HWXLR8/beef-board/(threads)

Thread 10 (2023-06-08):

PCB does not revert back to reactive lighting mode after entering HID mode

HWXLR8, 2023-06-08:

Closed 2023-08-30.

Thread 6 (2023-06-08):

TT drops inputs on startup

HWXLR8, 2023-06-08:
@supervaka wondering if you have encountered such issues. Occurs on V1+V2.

Steps to reproduce:

1. launch iidx
2. card in
3. select mode (in my case p-free)
4. when using the TT to select time, there are a few seconds of no response

Once the TT begins responding it is fine for the entire session and all sessions afterwards, but relaunching the game seems to cause it.

HWXLR8, 2023-12-18:
I have not been able to reproduce this issue on any device other than the PWAN. I am wondering if this may be an issue with DAO cheaping out on the PWAN photo-interrupters/related HW. This occurred on both the stock PWAN pcb, and all revisions of beef board. Since beef boards are out in the wild now, if nobody reports the same issue within the next month, I will close.

Closed 2024-01-12.

Thread 16 (2023-12-17):

TT reading innacurately on rapid rapid inputs

Mechada2dx, 2023-12-17:
When spinning the turntable slowly it cycles through fine. but when spinning faster, it looks like a temporal aliasing issue might be happening. Tried on a DAO PCB (SS001 V1.20) with the exact same setup, and I didn't encounter any issues similar to this one.

Going back to 72 teeth plate with the beef-board made everything work as it should.

HWXLR8, 2023-12-18:
renaming this issue. Since we confirmed this also occurs on 80T plate, I am convinced this will occur on any TT given a rapid enough input. Characteristics of this failure are that given a rapid enough input frequency, TT reading will appear to slow down, and occasionally read the wrong direction. All of these are indicative of dropped inputs.

Closed 2024-01-28.

Thread 17 (2023-12-19):

Add option to turn on/off button LEDs

Mechada2dx, 2023-12-19:

HWXLR8, 2023-12-19:
@supervaka don't think this should be too difficult. What are you thoughts on toggling this using a button combo?

Closed 2024-01-26.

Thread 18 (2023-12-19):

Add Voltex FW mode

HWXLR8, 2023-12-19:
Been doing some thinking about this one, and it looks like we are going to need a special FW mode for voltex. There are a couple of hurdles:

1. The [encoders used in cryto's voltex controller](https://www.sensatec.co.jp/e/products/catalog.php/293/ST-ELV-24X35B-K_EN.pdf]) use a single 3 pin connector with a variable voltage output. Our design was made with the assumption that controllers will always use encoders with 2 data lines (either in a 2x 3pin format or combined in a single 4pin). As this is not the case, we can re-use one of the 3-pin encoder inputs as an input for these voltex encoders, but we will have to change how the input is handled in FW.
2. The lighting effects run down the sides on the SVRE9, which would also need special FW. Not even sure what type of LEDs this thing uses, but I will experiment and find out.

For now I think it is acceptable to have this a compile-time flag, eventually I would like this to be toggled using a button combo.

Assigning this to myself for now, @supervaka feel free to chime in with your thoughts

HWXLR8, 2024-05-13:
Support for sensatec encoders has been added in V6. We can keep this issue on hold until you have a board in your hands to try out.

ASleepyCat, 2024-05-13:
> Support for sensatec encoders has been added in V6. @ASleepyCat We can keep this issue on hold until you have a board in your hands to try out.

Since I only have an SVSE5, I won't be able to help on RGB LED stuff with the SVRE9 and FAUCETWO.

HWXLR8, 2024-05-13:
> Since I only have an SVSE5, I won't be able to help on RGB LED stuff with the SVRE9 and FAUCETWO.

No problem, LED support is low priority. I will eventually get my hands on a FAUCETWO

Closed 2024-06-26.

Thread 20 (2024-01-06):

Remote USB board with USB-C

ASleepyCat, 2024-01-06:
Instead of requiring two USB cables to power the IO board, develop a remote USB board that only requires one USB input (probably USB-C with PD).

HWXLR8, 2024-01-06:
Thanks for the feature request! The whole idea of of having a remote board was to allow the flexibility to implement such a feature in the future, and it is indeed on the development roadmap, albeit low priority.

ASleepyCat, 2024-06-14:
Apparently a USB-C specific USB 3.x mode can supply up to 3A? https://en.wikipedia.org/wiki/USB-C#USB_3.0/3.1/3.2
This might be enough where USB PD isn't needed.

HWXLR8, 2024-06-14:
Unfortunately the AT90USB1286 is not USB3.0 compliant, so this would not work.

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

I think we should still be able to make it work by integrating a USB PD controller on the remote board, but I have yet to do any experiments with this.

ASleepyCat, 2024-06-19:
I managed to power on my PHOENIXWAN with one USB-C cable using this [USB-C breakout board](https://www.amazon.com.au/dp/B0CXS6X4T6?psc=1&ref=ppx_yo2ov_dt_b_product_details). I think we could fairly easily adapt this design onto our daughter board.

It draws just under 2A with all lights on at full bright.
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

HWXLR8, 2024-06-21:
I agree, we could easily adapt this, but I only have 1 concern. USB3.0 and 3.1 (even if you're using USB-C) still only has a power cap of 900mA. Your motherboard is just violating those specifications (as many do). Furthermore, the AT90USB1286 is only USB2.0 compliant. It is my understanding that the USB PD specification is entirely separate from the USB2/3/3.1 spec and will allow for a negotiation of higher currents even for USB2.0.

ASleepyCat, 2024-06-21:
Are you sure? On Texas Instruments's USB Type-C and PD PDF, they list USB 2.0 w/ up to 3A/15W as one of the most common uses cases (https://www.ti.com/lit/wp/slyy109b/slyy109b.pdf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)

I've also read on various threads that USB power specs are actually minimum guarantees and not limits, although I don't know have a primary source for that.

HWXLR8, 2024-06-21:
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
Well would you look at that. I had no idea that this was the case. This is fantastic news, thanks for bringing it to my attention.

As for the minimum guarantees, for our use case a "minimum guarantee" is equivalent to a power cap. We do not know who will be plugging the device into what, and if their mobo only supports the minimum gurantee, we will trigger over-current protection. Regardless, if we offer USB-C this is a non-issue. I still wish to offer both choices, and as long as we make it clear in the documentation the limitations of USB-B, this should be no problem.

HWXLR8, 2025-05-02:
I have revisited this today, and I believe that the minimum guarantee of 1.5A would not be sufficient for our use case (your example shows ~2A peak current draw). Not all PC motherboards with USB-C ports will support the higher current modes:

> USB-C ports can advertise higher current capabilities-specifically, 1.5A or 3A at 5V-via the CC (Configuration Channel) pins. However, this is not mandatory for all USB-C ports. Only ports that are specifically designed and configured to provide 3A at 5V will do so; others may only offer the default current.

I wouldn't want someone to plug in a beef board just because its USB-C only to trigger OCP on their motherboard. @ASleepyCat what are your thoughts?

ASleepyCat, 2025-05-02:
> I wouldn't want someone to plug in a beef board just because its USB-C only to trigger OCP on their motherboard. [@ASleepyCat](https://github.com/ASleepyCat) what are your thoughts?

YubiDeck has two USB-C ports where you can plug in both cables if your ports can't supply enough power on one cable. Maybe we can do something similar?

I also think Windows will step in if it detects a USB device drawing too much power, I got that warning when I tried using the remote board with only one cable.

If we're going to stick with using two cables minimum, I think we should replace the USB-B ports with USB-C since I think people have more USB-C cables lying around than USB-B cables.

Thread 21 (2024-01-09):

Set up guide?

ASleepyCat, 2024-01-09:
Wiring up the buttons is straightforward and work fine, but the turntable is unresponsive (both in spicecfg and in Windows' controller testing tool) when connecting both photo interrupter cables to `DAO_E1P1` and `DAO_E2P1` . If I connect the second cable to `DAO_E1P2`, it causes spicetools to crash when setting up the analog controls. The turntable and centre bar LEDs also don't turn on when their cables are connected to `TT_LED` and `DAO_BAR` (centre bar lighting isn't implemented so that's understandable).

I'm probably doing something wrong, so could you detail which cables connects where?

ASleepyCat, 2024-01-09:
I changed back to the stock board and everything works fine there, so it's an issue with my board,

ASleepyCat, 2024-01-09:
Nevermind, for some reason I confused the TT headers and everything works now.

HWXLR8, 2024-01-09:
PM'd on sows

Closed 2024-01-09.

Thread 22 (2024-01-09):

Digital turntable input

Mechada2dx, 2024-01-09:
Mostly to play Lunatic Rave 2. Maybe a button combination or a required key to hold while plugging in?

HWXLR8, 2024-01-09:
Could you be a bit more specific as to what the issue is here? Is digital turntable input not working for you?

Mechada2dx, 2024-01-09:
is digital input even a thing with the beef-board?

HWXLR8, 2024-01-09:
@supervaka I remember you tested digital TT and it worked, am I misaken? Referencing the poorly named `analog_turntable.h`

HWXLR8, 2024-02-26:
@ASleepyCat no rush, as usual. Just reassigning.

Closed 2024-03-03.

Thread 28 (2024-01-18):

HWB left floating

HWXLR8, 2024-01-18:
HWB (PIN PE2) is left floating which causes undefined behaviour when trying to enter bootloader. According to the datasheet for the AT90USB1286:

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

This sequence is required to enter the bootloader.

HWXLR8, 2024-04-16:
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
Teensy++ schematic for reference

Thread 31 (2024-01-20):

Implement missing turntable lighting effects

ASleepyCat, 2024-01-20:
Demo can be seen in [tokaku's review](https://youtu.be/q30dw-_Zi90?t=113&si=M5yStXKrlUd08NM7) of the original PHOENIXWAN, which should be the same across the + and LMT versions of the con.

- [x] #43
- [x] #37
  * This can be improved to be prettier
- [x] #48
  * User adjustable shifting speed?
- [x] Static rainbow
- [x] Reactive spinning rainbow
  * The stock board's implementation feels pretty laggy and stuttery, hopefully we can avoid the same shortcomings
- [x] Reactive
  * This is currently a two-tone effect, maybe change it to be more like the stock board? Could also keep the current effect as a different mode
- [x] Breathing
- [x] #52

ASleepyCat, 2024-01-20:
infinitas-arcin and roxy-firmware both use FastLED for their RGB effects, but that requires us to switch over to C++ (at least partially).

I tried to make a PoC, but I ran into weird compilation errors after including FastLED. Could just be an issue with how old my install of `avr-gcc` is, haven't tested it with a recent version yet.

HWXLR8, 2024-01-20:
I am aware of FastLED, but I have never used it myself. I was under the impression that it had a dependency on core Arduino libraries, is that not the case? For the record I don't have a problem with switching to C++.

ASleepyCat, 2024-01-21:
FastLED is available as a library in the Arduino IDE, but there's no hard dependency.

Closed 2024-02-21.

Thread 35 (2024-01-22):

Add support for PHOENIXWAN audio jack

ASleepyCat, 2024-01-22:
PWANs have an audio jack where you can plug in an audio source to get audio-reactive centre bar effects. It would be nice to have this to have complete support for all of the PWAN's features.

HWXLR8, 2024-01-22:
Our current PCB is incapable of supporting this and would require a new revision. This was a notable omission during the design since I am not sure it is possible to analyze audio in real time using our microcontroller. I believe the phoenixwan offloads this to a separate IC. Althought it is nice to have, the effort here would be would be considerable and is unlikely to be done in the future unless somebody else picks this task up. Marking as low priority.

Thread 42 (2024-01-30):

B8-B11 not fully supported by INFINITAS

Mechada2dx, 2024-01-30:
I've been testing INFINITAS with beef-board and from what I can see the game only reads from B9 to B12 respectively for start button and stuff. I can see this still working fine for a 2 button controller since you can just plug in B9 and B10, but for PWAN/RED (4 button controllers overall) this could become an issue specially for a RED since you need 2 PCBs.

HWXLR8, 2024-01-30:
@ASleepyCat / @supervaka I have confirmed on my end that B8 is unresponsive on infinitas. What do you say we kill B8 and just map B1-B7 then B9-B12?

Closed 2024-02-26.

Thread 44 (2024-02-01):

Version 5 PCB to-do list

HWXLR8, 2024-02-01:
- [x]  Fix chip reset (https://github.com/HWXLR8/beef-board/issues/28)
- [x]  Reverse 4 pin encoder pin ordering (5ad248a44e940dccef677540d5273de8867dade5)
- [x]  Add jumper between BUS and AUX 5V (016214301a05c4844d6649bfeba64fc961c18a41)
- [x] Move pwan AUX 2-pin closer to 5-pin (7a32bb05fe54354f62b4c05a49bae48dec875169)
- [x] Add new slikscreen (044856f65555a47e1522f14873f55c4edff88f71)
- [x] Update BOM in README (114403c7b63636c8a7de8c8b4bd2b4dd8c75e62a)
- [x] Update PCB pics
- [x] Fix silkscreen to reflect missing B8 if necessary (N/A)
- [x] Add SDVX silkscreen (N/A)
- [x] Move 2N7002 transistors into clear view (4a06a141ca6fd4496f06b375f950cd44f228dda7)

ASleepyCat, 2024-03-14:
Would it be possible to relocate the USB power headers closer to the edge of the board? I managed to damage the 2-pin power cable while trying to get it out since it was so taught.

HWXLR8, 2024-03-14:
No problem, added to the list.

Closed 2024-05-04.

Thread 69 (2024-04-26):

Add support for AC SDVX encoders

HWXLR8, 2024-04-26:
https://www.sensatec.co.jp/e/products/catalog.php/488/ST-ELV-24Y36G_EN.pdf

HWXLR8, 2024-04-27:
9e67e29ac9a81033c396567d0afec199287f518a

HWXLR8, 2024-05-08:
V5 uses a 3pin JST ZH connector for SDVX, and the pinout is reversed... JST PH seems to fit. The correct connector according to the datasheet is ZHR-3, whatever that is...

HWXLR8, 2024-05-13:
Fixed in v6

Thread 71 (2024-05-11):

V6 PCB to-do list

HWXLR8, 2024-05-11:
- [ ] move right group of JSTs equidistant from mounting holes
- [x] fix SDVX connector size and pinout (https://github.com/HWXLR8/beef-board/issues/69)

Closed 2024-05-13.

Thread 73 (2024-05-16):

Binding inputs on first connect causes incorrect reading

HWXLR8, 2024-05-16:
I believe we discussed this issue before, but when I am binding buttons, sometimes the first input is incorrectly read as either `Z-` or `Y-`. Just happened to me now based on latest commit (4f61eb2b061f3766c839e723c38ace13b96b4ea2). Testing on V3, but that should not make a difference.
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

Closed 2024-05-17.

Thread 75 (2024-05-17):

Add support for second rotary encoder

HWXLR8, 2024-05-17:
SDVX can use two types of encoders, photointerrupters (same mechanism as IIDX TT), and the sensatecs which act as analog potentiometers. This issue is only for the photointerrupter type encoder.

ASleepyCat, 2024-05-18:
How about copals?

HWXLR8, 2024-05-18:
You referring to these guys?
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
If so, then I have no plans to support these for now. I can't imagine anyone building a controller would opt to use these instead of something more "pleasant".

Closed 2024-06-26.

Thread 79 (2024-06-10):

Change remote board to use USB-C ports

ASleepyCat, 2024-06-10:
I have a bunch of USB A-to-C cables lying around, but no A-to-B cables. I figure that A-to-C cables are probably more available for the average person, so it might be better to change the ports to USB-C.

HWXLR8, 2024-06-21:
Closing this as a duplicate of #20

Closed 2024-06-21.

Thread 82 (2024-06-23):

Add support for Infinitas turntable lighting setting

ASleepyCat, 2024-06-23:
Haven't seen any documentation on how Konami sets their turntable lighting colour. I presume it's via HID but I guess the game first checks if the connected controller is capable since I can't see any HID OUT reports in Wireshark.

ASleepyCat, 2024-06-26:
I wonder if it's as simple as using the correct PID. @HWXLR8 do you know what the IIDX pro controller's PID is?

Thread 89 (2024-07-22):

Lunatic Rave 2 not working with beefboard anymore

Mechada2dx, 2024-07-22:
Ever since I switched from purple beefboards to the newer black ones, LR2 won't take input from them anymore, digital turntable still works though. I've tried 2 USB mode instead of 1 USB and even tried running LR2 on different computers but still nothing.

HWXLR8, 2024-07-22:
@ASleepyCat there should be no functional difference between these PCB revisions (v4 vs v6), I believe this is a FW regression.

ASleepyCat, 2024-07-23:
@Mechada2dx Could you see if SDVX mode works? Just want to check a theory.

@HWXLR8 Maybe, if there's a handy way of embedding the current commit hash into the fw. I know roxy-firmware shows the board fw version somewhere in roxy-tool (and probably the same with whatever arcin uses for its config tool), but we only have a rudimentary fw flashing tool.

ASleepyCat, 2024-08-03:
I've identified the issue and pushed the fix as part of #88. It's untested though since I can't get to the key config, but button inputs should at least be working again.

Closed 2024-08-19.

Thread 90 (2024-07-23):

Embed FW version into FW

HWXLR8, 2024-07-23:
We currently have no idea what FW version is flashed to the board. For debugging purposes, this is crucial information. My proposed solution is to write the FW version to a specific address in EEPROM, then read back the value in beef-tool using `avrdude`. My main concern is what constitutes the "FW version". Since we combine the pcb design, fw source, and beef-tool all in one repo, changing things completely unrelated to the FW will change the hash. We could introduce our own versioning system, but that feels a bit silly. @ASleepyCat thoughts?

ASleepyCat, 2024-07-23:
I guess the "proper" solution would be to split the hardware, firmware, and utility tools into their separate repos, akin to what `roxy-board` does. `beef-board` is essentially a monorepo, and there's no good way to do separate versioning of individual components AFAIK for that style of repo (at least without a manual versioning system).

We could just be lazy, and take the commit hash and say that's good enough since we'd be able to look through commit history to see any nearby relevant changes to the problem commit.

HWXLR8, 2024-07-23:
I elect that we take the lazy approach since the hardware components going to be receiving very infrequent updates going forward. I'll take ownership of this issue since I worked on the FW flashing tool.

ASleepyCat, 2024-07-24:
I think ideally we'd use HID to report back this type of information, but yeah storing it in EEPROM will do for now.

Closed 2024-09-26.

Thread 95 (2024-08-28):

PS2 support

ASleepyCat, 2024-08-28:
I guess this is something someone might want in the future.

Might require a hardware update. [roxy-firmware uses SPI](https://github.com/veroxzik/roxy-firmware/blob/roxy/roxy/spi_ps.h) for PS2 support, not sure how that would work in AVR.

HWXLR8, 2024-08-28:
So this connector breaks out the SPI pins on our microcontroller:

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

we would need to make a special adapter which plugs into this, but at least no new hardware revision is required

ASleepyCat, 2024-08-29:
What about Dao's [PS2 adaptor](https://www.gamo2.com/en/index.php?dispatch=products.view&product_id=364)?

HWXLR8, 2025-04-19:
> What about Dao's [PS2 adaptor](https://www.gamo2.com/en/index.php?dispatch=products.view&product_id=364)?

I wonder if this is doing any magic handshake with DAO controllers, or whether it just translates HID. I need to get my hands on one of these.

ASleepyCat, 2025-04-20:
> > What about Dao's [PS2 adaptor](https://www.gamo2.com/en/index.php?dispatch=products.view&product_id=364)?
>
> I wonder if this is doing any magic handshake with DAO controllers, or whether it just translates HID. I need to get my hands on one of these.

Probably (hopefully) no weird magic/proprietary protocols, considering it supports official Konami controllers.

HWXLR8, 2025-04-20:
Managed to get my hands on an adapter and a PS2 copy of Empress. Should be arriving in the next few weeks, will update with results

Thread 96 (2024-08-28):

Implement custom bootloader

ASleepyCat, 2024-08-28:
Would allow us to automatically switch beef-board into bootloader mode and back to application code without having the unplug and replug the board.

Also serves as groundwork for flashing via a config tool in the future.

Some references:
* [LUFA's HID bootloader](https://github.com/abcminiuser/lufa/tree/master/Bootloaders/HID)
  * Only the bootloader portion, doesn't have examples for how to switch into bootloader mode from application code
* [mon's Pocket Voltex](https://github.com/mon/PocketVoltex)

HWXLR8, 2024-08-28:
So the way Arduino bootloader decides whether to jump to bootloader is to listen for a sequence like:

1. Host connects to mcu via serial terminal
2. Host requests change in baud rate

This is a strange enough sequence that the user would never do it, and it still allows to the user to use a serial terminal if they need it.

We do not have to have as complicated of a handshake as the arduino bootloader since we are not a generic microcontroller pcb, maybe just listen for a serial terminal connection and jump to bootloader when the connection is established.

ASleepyCat, 2024-08-29:
I was more thinking of implementing an HID bootloader so that our board doesn't require drivers to update fw. But I imagine we won't be able to feasibly flash a custom bootloader onto existing boards, so should we just use the default bootloader that comes with our MCU?

ASleepyCat, 2024-09-01:
I'll work on this after #98. Our detection method might need to change depending on what we're able to do from the browser.

Thread 98 (2024-08-29):

Implement config tool

ASleepyCat, 2024-08-29:
Using only button combos to change settings is becoming a bit cumbersome, mostly because I don't remember the combos and have to keep going back to the README. On older controllers, changing turntable related settings would be very hard since they might not even have turntable LEDs. We might also want to add a setting in the future that would be infeasible with just button combos e.g. digital TT sustain.

Some approaches:
* Web config tool with WebUSB
* Traditional desktop program
* Both (Electron, Tauri)?

I'm mostly in favor of a web-based config tool since that would simplify testing and it's also the flashy new thing. I haven't done web dev in ages though and I haven't done web hosting before, so I'm amenable to making a desktop program instead.

HWXLR8, 2024-08-29:
My vote would be for a desktop program. It could still be web-based, just running locally. I would be fine with covering hosting costs and handling the infrastructure side of things, but I cannot offer much help with JS. I would certainly not be in favor of using any electron based bloatware though. A simple HTML+JS website would be sufficient.

Would we be ditching the existing key combos? I would like to keep them around.

ASleepyCat, 2024-08-29:
I'm mostly concerned about cross platform compat, having a website makes that way easier for me since I only have a Windows machine. For now, we can just have the user open the page locally; we can worry about hosting for another time.

> Would we be ditching the existing key combos? I would like to keep them around.

No they'd still be there, I don't see any reason to get rid of them.

HWXLR8, 2024-09-01:
Sounds good, I think we're on the same page here. I see no problem with the config tool displaying FW version. I assume this config tool would replace `beef-tool`?

ASleepyCat, 2024-09-01:
> Sounds good, I think we're on the same page here. I see no problem with the config tool displaying FW version. I assume this config tool would replace `beef-tool`?

Ideally yeah, but that's going to have to be done later since I'd need to learn the Atmel DFU protocol - I don't think there's a JS library so I'd need to do implement that from scratch. Alternatively, we could just point people to QMK Toolbox since that's already a fleshed out flashing tool.

ASleepyCat, 2024-09-01:
Oh also don't expect much from me for design stuff lol, I'll try to at least not make it look horrible.

ASleepyCat, 2024-09-01:
Apparently there's a PR that adds some WebUSB stuff in LUFA (https://github.com/abcminiuser/lufa/pull/103), but for some reason there's been no progress for years. I don't think it's strictly necessary for us to add WebUSB stuff in our firmware, maybe further down the road if we want to implement some niceties (https://developer.chrome.com/docs/capabilities/build-for-webusb#webusb_descriptors).

Closed 2024-09-26.

Thread 108 (2024-09-30):

Add DFU flashing to web config

ASleepyCat, 2024-09-30:
AFAIK no one else has done this in JS? Can't find any existing (open source) examples on Google.

ASleepyCat, 2024-10-14:
`beef-tool` can be kept as an alternative method in case someone doesn't want to or can't use a browser with WebHID support.

HWXLR8, 2024-10-14:
Yeah, as someone who exclusively uses firefox (no hid support), I'd rather use beef tool than install another web browser

Closed 2025-02-02.

Thread 112 (2024-10-13):

Web Config site unable to function due to WebUSB blocking

drugexchange, 2024-10-13:
There is currently an issue where me and another user have an issue attempting to use the web config provided on the readme. Upon attempting to connect the board to the webconfig any chromium browser cannot detect it. I took a look through chrome://usb-internals and it did report that WebUSB was blocking it from interacting with anything on chrome. Unsure if this is the reason that the board cannot be used on the web-config.

HWXLR8, 2024-10-13:
@ASleepyCat Thoughts?

ASleepyCat, 2024-10-14:
I'm assuming you're using Chrome? Chrome should support WebHID, I tested with Edge and that also works. Have you changed some privacy settings that might block WebHID?

drugexchange, 2024-10-14:
Checked my privacy settings HID isn't getting blocked by it. However, I am using the stock firmware that was used. Unsure if its a recent firmware or outdated one.

HWXLR8, 2024-10-14:
@ASleepyCat The firmware I shipped should have been from this commit 4b8f684e9ef40fe88813fcf7988640c37cfeebc6. It should be pretty recent.

@drugexchange could you please try updating to the latest FW anyway? You can find instructions here:

https://github.com/HWXLR8/beef-board/tree/master/beef-tool

You can manually put the pcb into programming mode by pressing the button in the corner of the board. You can find both the latest FW and the FW flashing utility here:

https://github.com/HWXLR8/beef-board/actions/runs/11274018346

drugexchange, 2024-10-14:
Great news for both of you guys after flashing the firmware provided by @HWXLR8 it now gets detected by the web config so yeah probably the wrong firmware got put on the board. This can now be closed by either of you two.

Closed 2024-10-14.

Thread 115 (2024-10-23):

Upgrade to Svelte 5

ASleepyCat, 2024-10-23:
Svelte 5 finally has an official stable release (https://svelte.dev/blog/svelte-5-is-alive).

Hopefully will fix the double update bug.

ASleepyCat, 2024-11-03:
Likely won't upgrade anytime soon as Svelte 5's new runes system breaks our current way of detecting a config update. Class property updates no longer trigger side effects on the class instance without some sort of wrapper.

If this proposal (https://github.com/sveltejs/svelte/issues/10560) gets implemented, I'll have another try at this. Otherwise, I don't exactly feel like adding a ton of boilerplate for an upgrade (or if there's a better way).

Closed 2025-06-07.

Thread 119 (2024-11-05):

HID button lights don't get cleared properly

ASleepyCat, 2024-11-05:
If you bind one of the HID button lights while it's on then unbind it, the bound button light won't get cleared properly and will stay lit until HID standby.

ASleepyCat, 2024-11-05:
Actually might be a bug in SpiceTools?

ASleepyCat, 2025-02-24:
Closing as it's probably a SpiceTools quirk.

Closed 2025-02-24.

Thread 120 (2024-11-19):

beef-tool QoL improvements

HWXLR8, 2024-11-19:
beef-tool's implementation was hacked together, some basic QoL improvements are in order:

- [ ]  Change the default toolbar icon
- [ ] Add adaptive dark mode according to user's desktop theme
- [ ] Disable ability for user to type in the status box (it is currently an input box...)
- [ ] Find a way to avoid triggering windows defender. Not sure if this is possible since we are embedding `avrdude` in the executable

HWXLR8, 2024-11-20:
Gonna put this one on the back burner for the time being as I'm going to be quite busy for the next 2-3 months.

Thread 137 (2025-07-20):

Board seems to shut off on its own after a few minutes of playing (9keys/popn)

abadejos, 2025-07-20:
Hello, one of my friends gave me a beef board to drop into my pop'n dao. However, sometimes when I'm playing, the board will seemingly "shut off", no longer registering any inputs, and it doesn't turn back on again. Even unplugging it and plugging it back in doesn't seem to work. The only solution is to restart my computer, and even then, sometimes it's not detected by my computer.

My friend flashed it with the newest firmware on github, but the webui seems to say that my firmware is out-of-date (if it's detected).
We don't think it's the cable, because he tested it on another device for a good while, and it worked fine. I also wiggled the board to see if there was any loose connections, it didn't really make a difference. I've also disabled LEDs in the webui, it doesn't seem to change anything. The controller is currently on joystick mode.

I've tested this on: pop'n data (through spice2x and on windows), Lunatic Rave 2 (on windows), and Beatoraja (on Linux). Initially, I thought this was an issue with Linux, but it seems to do this strange shutting-off even on windows. If there's anything I can try to fix this issue, I'd greatly appreciate it.

HWXLR8, 2025-07-20:
Sorry to hear you are having issues. A couple of questions:

1. You mentioned that you tried on Linux/Windows, are these both on the same PC? Is this behavior observed on multiple PCs? Just want to rule out the host.
2. Is the PCB being used in 1-USB or 2-USB mode? You can check the jumper in the bottom right:
  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

3. Was this board assembled by your friend? Or was it purchased through beef on discord?

@ASleepyCat What is the FW version cutoff for the web UI flashing? Theoretically they should be able to update to latest using beef-tool then switch to web UI afterwards, right? Although I do not suspect the FW since they mentioned that unplugging/replugging has no effect.

abadejos, 2025-07-20:
hi, i'm going to answer what i can and edit later, it's like 4 am in my timezone so i cant open the controller right now. i'll update this when i'm able to, thank you both for the prompt responses

1. yes, this is on the same pc. i will add that he gave me an arcin board earlier, and it had the same issues (board shutting off). we thought it was a faulty board so he gave me a beef board
2. will check in a few hours, can't open up controller right now
3. no, it's not recognized by the os. i've been plugging it in and unplugging it on the front panel (i've tried the back and it doesn't seem to make a difference), and it's not being recognized right now at all. can't check the kernel right now since it's been a few days that i've played a game with this on linux. i do have this in my dmesg though... not sure what over-current condition is:

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
(The latest message popped up when I unplugged the beef board from my computer)
(I disabled XHCI on my BIOS for right now, and I set legacy USB support to auto. That's all I changed in my bios settings. )
4. this board was bought through someone on discord. he did not assemble it
5. can't check hash display because the board isn't being recognized at all at the moment

I'm noticing odd behavior when I plug/unplug the controller. It's not a device on lsusb, yet, when I plug it in, my phone no longer gets recognized as a storage device and a few devices disappear. First one is with the controller unplugged, and the second one is when it's plugged in.

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

HWXLR8, 2025-07-21:
A couple of things stand out to here.

1. The issue was present with the arcin, before beef board was introduced into the system.
2. The over-current protection (OCP) is being triggered on _multiple_ ports.

OCP is a protection mechanism which prevents your USB ports from drawing too much current, and it will cut off current to the device to protect it. This is why you are seeing the "shutting off" behaviour. OCP often takes some time to cool down once it is triggered, which explains why sometimes even rebooting your computer doesn't help. OCP is not perfect, and it does not guarantee that your motherboard was not damaged by the device. In fact, the motherboard might not have been damaged by a USB device at all. I have seen instances in the past where a general motherboard faults causes OCP and some ports just stop working permanently. Regardless, the fact that this issue was present with the arcin (before beef board was introduced into the system) rules out it being the cause.

Try unplugging your PC from the wall and holding down the power button for a bit, this should drain any residual charge. Once that has been done, plug in a known good device with a known good cable (maybe your smartphone), and check if OCP is still triggered. If it still has, your motherboard is likely damaged.

Closing this issue as I do not believe its an issue with beef board specifically, but feel free to comment.

abadejos, 2025-07-21:
Thanks for the insight... yeah, it seems like I have to replace my motherboard. Oops. Does the beef board run with a lot of current by default, though? I tried disabling LEDs on the webui to see if that'd make it use less power, but it didn't really make a difference. I'm kind of glad my board isn't faulty, though, but I'm just trying to see what I should do so OCP won't trigger in the future.

Closed 2025-07-21.

Thread 139 (2025-08-20):

V6 PCB will connect, but not actually register inputs/show lighting.

alixdotsh, 2025-08-20:
Heyo. I’ve been switching my deck from bi2x to beef boards and I’ve run into an issue. Up to just a while ago the board was working perfectly fine, inputs were being registered when pressed, along with their LEDs, turntable lighting was working too, but after more troubleshooting it now does not. I unplugged everything from the board when I was routing my cables in the deck to the board and I plugged everything back in. I tried plugging it into my computer and no inputs or even the turntable are being registered on hardware tester, button LEDs/TT LEDs do not work either. I am on the latest firmware via beef-tool.

edit (22:10 est): turntable leds work again idk what changed lol

Here is a list of things I have tried to do while troubleshooting:
- different data cables
- restarting my pc
- try plugging it into a different pc
- reinstalling drivers and re-flashing firmware
- reset button on pcb
- different ports in computer
- try a different board (I was shipped 2)

If there are more things you’d like to know, or any other methods to troubleshoot, please do let me know and I’ll get back to it as soon as possible.

alixdotsh, 2025-08-22:
The controller is an actual arcade controller yes. A friend of mine was using it for a while before shipping them out to me, they were working when I was plugging everything in initially to double check.
> * I assume your beef board was working before you swapped out your bi2x board, was it working afterwards as well?

Yes. Until I took everything off the board to not have a messy internal when I screw everything back together.
> * Have you tried using your bi2x board again and see if that still works?
The bi2x board still works.
> * Do you have enough slack with your wires after you re-routed them and made sure they aren't damaged in some way?
Define "slack," im still new to this kind of stuff, i also didn't do the wire making myself. I haven't actually checked to see if they are damaged or not properly touching the connectors, but I can try to do that. I will mention that one button LED lit up for a millisecond once when I was reflashing firmware.
> * How many USB cables are you using to power the board?
2 cables. Data, and then power.

I will mention I am running modified firmware, but I highly doubt that is the problem because I used official firmware and it wasn't a fix. The only modification is the amount of LEDs being addressed for the turntable.

HWXLR8, 2025-08-24:
It is pretty difficult to debug HW issues without being physically present. The failure mode is quite strange considering it once worked then suddenly stopped. That rules out many issues with pinouts.

>Up to just a while ago the board was working perfectly fine, inputs were being registered when pressed, along with their LEDs, turntable lighting was working too, but after more troubleshooting it now does not.

Can you elaborate on what occurred during this period?

>2 cables. Data, and then power.

Are both cables plugged into the PC? Both cables supply power to different parts of the circuit so they need to share the same GND reference.

>I will mention I am running modified firmware

Did problems begin after flashing the modified FW or before?

alixdotsh, 2025-08-24:
> Can you elaborate on what occurred during this period? What did you change between when it was working and when it began acting up.

Wednesday morning at id say around 9:30am I had unplugged the board from the PC, and all the cables that were connected to the board. All that I had done was try to cable manage and make things look neater, because admittedly the provider sent me their wires and it wasn't the neatest job, but it worked. I was routing cables through the deck so that there were not just a big group of cables possibly getting tangled within each other. I then started to plug everything back in to the board (id say this is around 10am). Once everything was plugged back in, that is when the issue started.

> Are both cables plugged into the PC? Both cables supply power to different parts of the circuit so they need to share the same GND reference.

Both are plugged in to the PC, I tried just the data cable (where just the button LEDs would work), and then both. Neither was a fix to the issue. It's very weird, because I can control the turntable lighting through the web config, and it works instantly, but nothing else will. Keyboard mode doesn't fix it either.

> Did problems begin after flashing the modified FW or before?

It happened after. But again, I did try to flash back to official FW to see if it would fix it and it did not. The fork of the repository is public and it's on my profile, you can see all that I changed (a single line in the makefile) and the workflows/prod that was being done.

> It is also very telling that the same issue is occurring with both boards, which rules out manufacturing defects. Did the person who provided you with the boards have any issues?

They told me they had no issues as it was working completely fine in their deck a couple of weeks ago, when they were playing BMS. They also have zero idea what is the issue.

Ultimately im just worried that I somehow bricked the boards in a way, as I know that isn't something that can really be fixed. But im trying to be optimistic and not think that's the case.

HWXLR8, 2025-08-24:
Considering you are able to flash the device, the likelihood of the board being bricked is vanishingly small. That being said, there is still something strange going on here. When you changed the firmware, how did you build it? Manually? or using the binary built by the github workflow? How did you flash the firmware? I looked at your fork and I agree that your changes are unlikely to be the cause..

@ASleepyCat do you know of any way in windows to check if the HID device is presenting any buttons?

alixdotsh, 2025-08-24:
> When you changed the firmware, how did you build it? Manually? or using the binary built by the github workflow? How did you flash the firmware?

I built it using the binary built by the github workflow. I don't know if that was exactly the one used in this repository but I tried to match action steps and went from there. I flashed it using beef-tool, as the web config flashing never was a success for me.

alixdotsh, 2025-08-29:
hiya, just giving an update. i left all but one battery plugged in and that was not registering either. sorry for late resopnse, work has been hectic this week.

HWXLR8, 2025-08-31:
Unfortunately at this point there is no other support I can offer. The fact that the board was working before the cable management suggests that some sort of user error has occurred. I will be closing this issue, if in the future you come across any promising leads, feel free to re-open the issue and I will try my best to help.

Closed 2025-08-31.
