HWXLR8/beef-board/(commit log)

2023-03-29 switch from dfu-programmer to avrdude
2023-04-02 done initial schematic
    [2D-EGGS.kicad_pcb, 2D-EGGS.kicad_sch]
2023-04-02 turn button LED on when pressed
2023-04-02 wire unused pins to 24-pin connector
    [2D-EGGS.kicad_sch]
2023-04-03 rough pcb layout, remove auto_saved_files
    [2D-EGGS.kicad_pcb, 2D-EGGS.kicad_sch]
2023-04-03 aligned mounting holes + bottom JST connectors
    [2D-EGGS.kicad_pcb]
2023-04-03 aligned all mosfets
    [2D-EGGS.kicad_pcb]
2023-04-04 routing done
    [2D-EGGS.kicad_pcb, 2D-EGGS.kicad_sch]
2023-04-04 DRC passing, change copper fill to hatch
    [2D-EGGS.kicad_pcb]
2023-04-14 2N7000 -> 2N7002. add series resistor to reset switch
    [2D-EGGS.kicad_sch]
2023-04-18 add silkscreen
    [2D-EGGS.kicad_pcb]
2023-05-02 Add prototype firmware support for buttons, TT, and HID lighting
2023-05-22 Refactor for consistent style
    * refactor input and led of buttons
    * fix bug in process_button(), refactor Lights_SetState()
    * refactor turntable logic, style changes
    * rename most names to snake_case, remove OUT report struct and just use 16 bitfield for HID led_state
    * convert all indentation to spaces, further refactor turntable logic,
    [beef.c, beef.h]
2023-05-28 update schematic, pcb layout WIP
    [2D-EGGS.kicad_pcb, 2D-EGGS.kicad_sch]
2023-05-28 modify pcb layout, align many footprints
    [2D-EGGS.kicad_pcb]
2023-05-28 v2 routed
    [2D-EGGS.kicad_pcb, 2D-EGGS.kicad_sch]
2023-05-28 v2 finalized
    [2D-EGGS.kicad_pcb]
2023-06-04 update connector enumuration to match standard iidx controller layout
    [2D-EGGS.kicad_pcb, 2D-EGGS.kicad_sch]
2023-06-06 fix unconnected pad on B11 MOSFET
    [2D-EGGS.kicad_pcb, 2D-EGGS.kicad_sch]
2023-06-06 abstract button+LED pin configuration into config.h/pin.h
2023-06-15 add fuse target
2023-06-18 v3 routed
    [2D-EGGS.kicad_pcb, 2D-EGGS.kicad_sch]
2023-06-18 remove J* indicator for PWAN AUX power
    [2D-EGGS.kicad_pcb]
2023-06-20 finalize V3
    reduced JST-XH holes from 0.95mm -> 0.9mm, minor changes to layout
    [2D-EGGS.kicad_pcb, 2D-EGGS.kicad_sch]
2023-07-02 reverse TT direction for infinitas support
    [beef.c]
2023-07-05 Add configurable TT sensitivity
    Default sensetivity sets the TT to a 2:1 ratio (2 pulses = 1
    input). Updated the config.h pin mapping to reflect V3 pin
    wiring. Also cleaned up some trailing whitespace.
2023-08-07 rename project
    [beef-board.kicad_pcb, beef-board.kicad_sch]
2023-08-07 add pcb pict
2023-08-07 fix silkscreen error on J11
    [beef-board.kicad_sch]
2023-08-26 add remote board
    [remote-board.kicad_pcb, remote-board.kicad_sch]
2023-08-26 fix silkscreen error on pcb
    [beef-board.kicad_pcb]
2023-08-26 fix turntable sensitivity bug (#12)
    fix turntable sensitivity bug
    tt_position's type is uint16_t for easier math, converted back to an int8_t in HIDReport
    [beef.c, beef.h]
2023-08-30 Implement turntable lighting, plus minor bug fixes
    Minor fixes:
    1. Fix turntable sensitivity bug when changing directions.
    2. Revert back to reactive lighting mode after 5000ms of
    not receiving any HID reports from host pc.
    [analog_turntable.h, beef.c, beef.h, config.h, timer.h]
2023-11-12 finalize v4
    [beef-board.kicad_pcb]
2023-12-29 Add button combo to reverse TT direction
    [beef.c, beef.h, config.h, timer.h]
2024-01-14 Implement config system, mode notify, code refactoring (#25)
    Implement basic config system/mode switch notification plus structural refactoring
2024-01-16 add BOM
2024-01-16 add remote board BOM
2024-01-16 Implement TT effects mode switch (#26)
    Closes #24.
    * Button combo is B2 + B8 + B11
    * This matches the PWAN combo the closest, accounting for the lack of extra buttons
    * Change HID expiry timer to 1 second
    * During HID standby mode (when no HID report has been received after 1 second), the turntable will be lit white in HID mode
    * Fix buttons 10 and 11 being swapped
    * Add placeholder ring light mode enums
    * Placeholders are based on the stock board's turntable effects
    * This is so that we don't have to do weird config migration stuff when we add new TT effect enums
    [beef.c, beef.h, config.c, config.h, tt_rgb_manager.c]
2024-01-17 Clean up HID descriptor (#27)
    - Reduce number of buttons to 13, this includes the 11 physical buttons as well as +/- digital TT
    - Remove Z axis
    - Remove unneeded HID button light entries (This will break existing TT light binds)
    - Change X and Y HID joystick reports to `uint8`
    [beef.c, beef.h]
2024-01-20 Implement deadzone adjustment (#29)
    - Implement deadzone adjustment, turntable config lighting effects
    - Add helper function to check if a timer is active
    - Fix type casts
    - Fix reactive TT effect breaking on deadzone change
    [analog_turntable.c, analog_turntable.h, beef.c, beef.h, config.c, config.h, rgb.h, timer.c]
2024-01-20 Add button combo config to README
2024-01-20 Fix button combo table alignment
2024-01-21 Declare structs in header files as extern to fix linking errors due to multiple definitionsto (#32)
    [analog_turntable.h, beef.c, pin.h, timer.h, tt_rgb_manager.c]
2024-01-21 Add FastLED (#34)
    - Add FastLED
    - Update credits
    - Add comment on pin mapping
2024-01-24 Implement centre bar lights and HID support (#36)
    - Implement center bar, HID lighting
    - Add center bar lighting change combo to README
    - Optimize build times
    - Remove unneeded timer
2024-01-26 Add button combo to disable LEDs (#33)
    - Add button combo to disable all LEDs
    - Optimise FastLED usage
    - Minor refactor
    ---------
2024-01-28 update lighting on a timer to reduce the number of computationally expensive calls to FastLED.show(); (#39)
    - update lighting on a timer to reduce the number of computationally
    expensive calls to FastLED.show();
    - add configurable TT ratio/LED refresh rate compiler flags.
2024-01-28 Disable FastLED dithering (#40)
    - Disable FastLED dithering
    - Change LED refresh default back to 40
    - Formatting fixes
    [beef.cpp]
2024-02-01 Fix LED flickering (#41)
    - Fix LED flickering
    - Reimplement micros() to get more accurate timekeeping
    - Constrain BEEF_LED_REFRESH to range [1, 400]
    [beef.cpp, config.h, fastled_shim.h]
2024-02-04 Implement user adjustable static colour TT effect (#45)
    - Implement user adjustable static colour TT effect
    - Split button combos into new file
    - Change default spin colour to aqua
2024-02-04 Force enable reactive LEDs during HID mode when button combo is pressed (#47)
    - Force enable reactive LEDs during HID mode when button combo is pressed
    - Remove unneeded branch condition
2024-02-26 Fix extra buttons not working on Infinitas (#55)
    [beef.cpp, beef.h, ticker.cpp, ticker.h]
2024-02-29 Add button debouncing (#57)
    - Add button debouncing
2024-03-07 clang-tidy fixes and refactoring (#59)
    - clang-tidy fixes
    - Remove unneeded makefile includes
    - Add note on TT deadzone
    - Refactor process_tt()
    [Descriptors.h, beef.cpp, beef.h, combo.cpp, config.cpp, config.h, fastled_shim.h]
2024-04-16 [PCB] Fix broken reset circuit
    - Remove unnecessary resistors on reset line
    - Pull HWB (PE2) low
    - Move B9/B10 to free up PE2
    [beef-board.kicad_pcb, beef-board.kicad_sch]
2024-04-18 [PCB] Reverse pinout on 4-pin encoders
    [beef-board.kicad_pcb, beef-board.kicad_sch]
2024-04-18 [PCB] Move 2-pin power for PWAN closer to 5 pin
    [beef-board.kicad_pcb]
2024-04-20 [PCB] Add jumper to select number of USB connections
    For users who wish to violate the USB standard and draw more than
    900mA from their PCs, they may jump the 2 pin connector designated
    "1USB" which combine +5V and +5VA lines.
    [beef-board.kicad_pcb, beef-board.kicad_sch]
2024-04-20 [PCB] Add questionable silkscreen
    [beef-board.kicad_pcb]
2024-04-20 update BOM to reflect v5
2024-04-20 [PCB] Move mounting hole silk to User.Drawings
    [beef-board.kicad_pcb]
2024-04-27 [PCB] add SDVX AC encoder connectors
    [beef-board.kicad_pcb, beef-board.kicad_sch]
2024-04-27 [PCB] Rework PCB layout
    - Move 2N7002 out from between JSTs
    - Move 牛 silk to inside MCU footprint
    - Adjust kirkland text justification
    - Minor JST spacing adjustments
    [beef-board.kicad_pcb]
2024-04-28 [PCB] Fix SDVX AC encoder routing
    - Add JST ZH footprint
    - Swap 3pin JST XH for 3pin JST ZH
    - Fix reversed pinout
    - Remove G** on rear silkscreen
    [beef-board.kicad_pcb, beef-board.kicad_sch]
2024-04-29 [PCB] hide SDVX* silkscreen, minor routing changes
    [beef-board.kicad_pcb]
2024-04-29 [PCB] remove ISP silkscreen
    [beef-board.kicad_pcb]
2024-04-29 [PCB] make GND plane solid fill
    [beef-board.kicad_pcb]
2024-05-04 [PCB] update pcb pics
2024-05-13 [PCB] Finalize V6
    - Replace SDVX AC encoder connectors with JST PH (from ZH)
    - Change silkscreen version indicator to V6
    [beef-board.kicad_pcb, beef-board.kicad_sch]
2024-05-13 [PCB] Update pics for V6
2024-05-17 Fix turntable misfiring on first input (#74)
    [beef.cpp, beef.h]
2024-05-19 [FW] Add fuse-dump make target
2024-05-20 [FW] Add button combo to enter programming mode on boot (#77)
2024-05-26 [DOC] PCB APPROVED BY KORS K
2024-05-26 [PCB][SCH] Clean up schematic
    [beef-board.kicad_pcb, beef-board.kicad_sch]
2024-05-31 [FW] Fix button pinout for V5 (#72)
    [config.h]
2024-06-05 [DOC] Update BOM
    closes https://github.com/HWXLR8/beef-board/issues/76
2024-06-26 Add support for multiple controllers (#80)
    - Add support for multiple controllers
    - Add macros for device and configuration USB descriptors, descriptor callback
2024-06-26 Expose number of RGB LEDs in makefile (#84)
    - Expose number of RGB LEDs in makefile
    - Normalise animation speed for different number of RGB LEDs
2024-07-02 Update FastLED to 3.7.0 (#85)
    - Update FastLED to 3.7.0
    - Fix makefile syntax error
    - Set FastLED's frame limiter to 0
    [rgb_helper.cpp]
2024-07-03 Fix rainbow static HSV not being inited correctly (#87)
    [config.cpp]
2024-08-19 Implement HID keyboard mode (#88)
    - Implement keyboard mode
    - Refactor HID report descriptors to use one descriptor, various code refactoring to remove function pointers
    - Fix keyboard mode reports not working properly by refactoring HID interface
    - Ignore button presses after boot, add ATTR_PACKED attribute to HID report structs
    - Fix LR2 compatibility
    - Add ATTR_PACKED to rgb_light
    - Fix X and Y axis for SDVX knobs being switched
    - Suppress some warnings in fastled_shim.h
    - Minor optimisation when ignoring button inputs
    [Descriptors.cpp, Descriptors.h, LUFAConfig.h, analog_button.h, axis.cpp, axis.h, beef.cpp, beef.h]
2024-08-25 Optimisation pass (#93)
    - Only call FastLED updates when necessary
    - Omit certain RGB update functions if respective LED counts are 0
    - Only update Rainbow lighting effects when necessary
    - Add warning for high BEEF_LED_REFRESH values
    - Optimise ticker, move some static class variables to global scope to reduce initialisation guards
    - Fix RGB animation normalisation factors being wrong
    - Reduce code size by removing parameters for globals
    - Omit entire LED update function if both ring and light bar LEDs are set to 0
    [analog_button.h, beef.cpp, beef.h, bpm.cpp, bpm.h, combo.cpp, combo.h, config.cpp]
2024-09-28 Handle suspend/wake events, fix buttons not being ignored after plug in (#101)
    [beef.cpp, beef.h, config.cpp, config.h, iidx_combo.cpp, rgb_helper.cpp]
2024-09-28 Fix not being able to exit out of sleep mode (#102)
    [beef.cpp]
2024-09-29 Fix indentation, rename DISABLE_LED combo enum to DISABLE_LEDS (#103)
    [iidx_combo.cpp]
2024-11-12 [PCB] Tighten drill holes, remove silk outlines on SMDs
    [beef-board.kicad_pcb, beef-board.kicad_sch]
2024-11-12 [PCB] Replace manual mounting holes with 6mm footprint
    [beef-board.kicad_pcb]
2024-11-12 [PCB] Add thermal reliefs
    [beef-board.kicad_pcb]
2024-11-12 [PCB] Tighten ISP/crystal holes
    [beef-board.kicad_pcb, beef-board.kicad_sch]
2025-02-03 Add various guardrails and user tips to DFU flashing page (#122)
    - Fix wrong PID being used for SDVX mode
    - Add various guardrails during flashing process
    - Add message about DFU drivers and add a link to the installer
    - Add pop up to warn users to not flash unknown firmware
    - Update web config screenshot
    - Update web config description to mention new firmware flashing capability
2025-02-08 [remote-board] fix reversed JST wiring
    [remote-board.kicad_pcb, remote-board.kicad_sch]
2025-04-13 Add outdated firmware warning to web config (#132)
    - Add warning to let user know if their firmware is outdated
    - Always shows reset config button
    - Fix spacing on error message
2025-04-19 [tt-adapter] add dao tt hw adapter
    [tt-adapter.kicad_pcb, tt-adapter.kicad_sch]
2025-05-15 Add support for tape LED data (#133)
    - Add support for reading tape LED data, add helper script
    - Add .vscode, .idea and build files to .gitignore
    - Combine spiceapi and beef-tool CI jobs
2025-09-14 Add adjustable button debouncing, rework button debouncing algorithm (#142)
    - Add adjustable button debouncing, rework button debouncing algorithm
    - Update web config image
    - Remove now unused compile flag
    - memcpy new config after USB handler processes config update
    - Change effactor debounce to 4
    [beef.cpp, beef.h, config.cpp, config.h, debounce.h, iidx_usb.cpp, iidx_usb.h]
2025-09-18 Move refresh rate, rainbow spin speed, and turntable LED settings to config (#145)
    - Move refresh rate, rainbow spin speed, and turntable LED settings to config
    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
2025-09-19 Fix flashing button appearing when no firmware file has been selected (#147)
2025-12-24 Fix config version upgrades not working properly, set default TT sustain time to 133ms (#151)
    [config.cpp]
2026-03-22 Fix digital TT outputs not having correct deadzone while turning, direction being reversed on count overflow (#152)
    [analog_button.cpp]
